astawu/Transmission_TeamOh-/PDR/CAD photos/overview.JPG

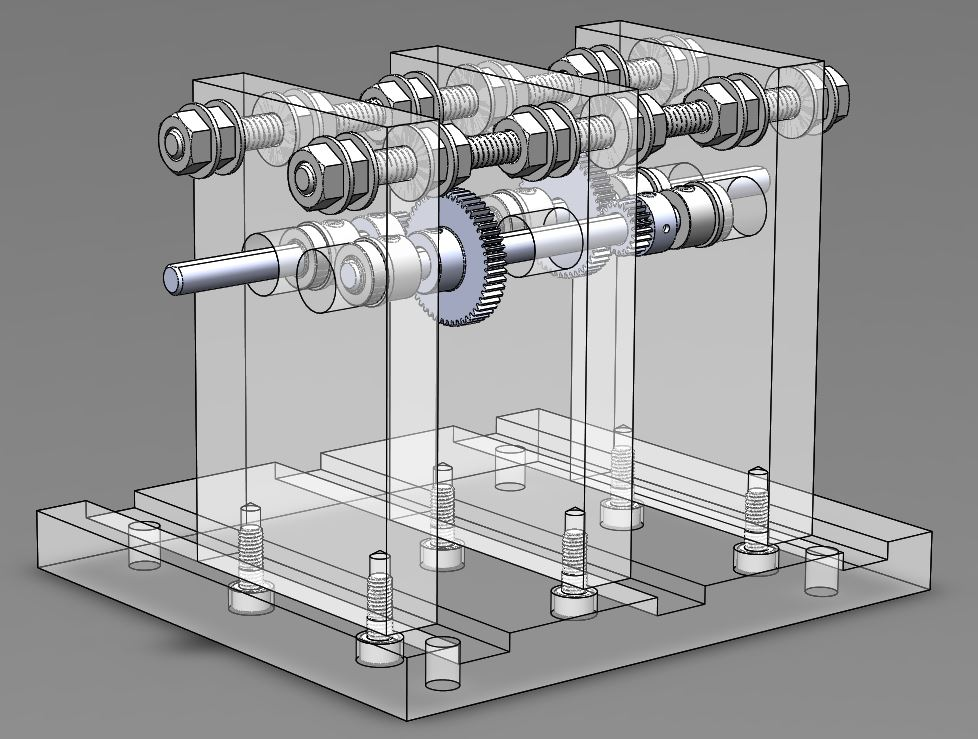
PDR/CAD photos/overview.JPG
