astawu/Transmission_TeamOh-/PDR/CAD photos/side.JPG

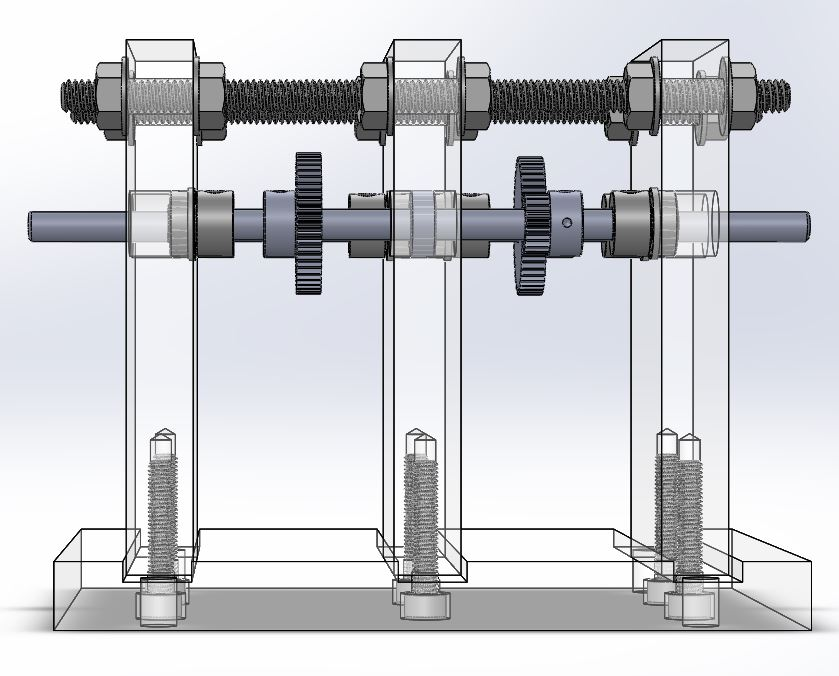
PDR/CAD photos/side.JPG
