astawu/Transmission_TeamOh-/README.md

# Transmission_TeamOh-
Transmission Competition Documents
