astawu/Transmission_TeamOh-/PDR/Transmission Contest PDR.pdf

# Transmission Contest PDR

# Zhong Huang, Cavin Huh, Asta Wu Team Oh

# Drawings and Decisions

# SolidWorks

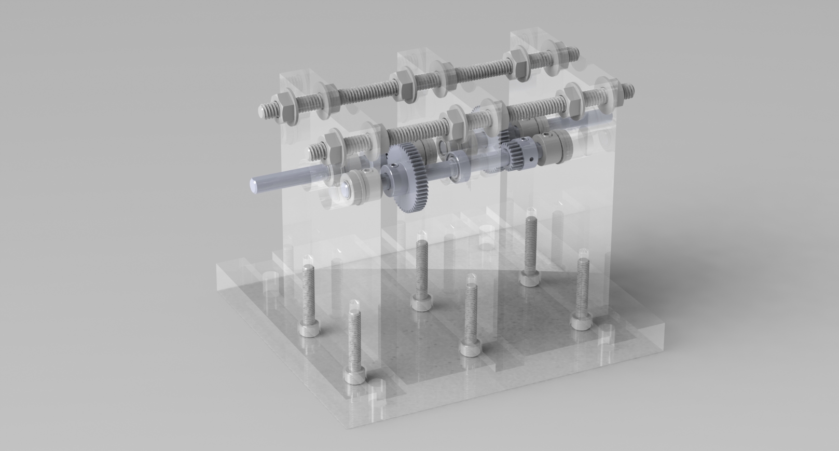
[picture p18: page 3]

# Overall design


# - Two stage inline drive - Three axles using spur

gears – most simple,

# cheap design, allows higher quality parts - 2.5 reduction at each gear interface = 6.25 overall gear ratio - Minimise size

# Gears


## - Gears: 20 teeth to 50 teeth for 2.5 ratio - Small gears instead of big – less inertia - 48 diametral pitch instead of lower values – more teeth for better meshing

## - Aluminium instead of plastic/steel – stronger than plastic, able to machine if needed - Set screw hub cap for D shaft – easily adjustable, strong

## - 20 degree pressure angle – only size available. Would have preferred 14.5 for

better meshing.

## - Wide face width (0.1875) – more contact area

# Bearings / Collars


# - Steel Ball Bearings for better efficiency / lower friction than bushings - Flanged instead of unflanged - so shaft/bearings are constrained - Set screw collars instead of – easy adjustment on D shaft, cheap

# - Smallest OD of ½ inch – fits press fit reamer in shop

# - Extended inner race – collars only contact inner rotating part of

bearing. Minimizes friction.

# - Initially wanted bearings with set screw collars – too expensive

# Supports


# - Machined slots at bottom for close, flat fit - 10-32 set screws - Using threaded rod and nuts for top support – allows for tighter shaft constraining - Flange nut to spread out pressure more - Shaft steel – more rigid than other materials. ¼ inch as most popular bore

size for gears.

# Calculations

# Forces, Normal Stresses, Deflections, Torques (done with maximum input torque)

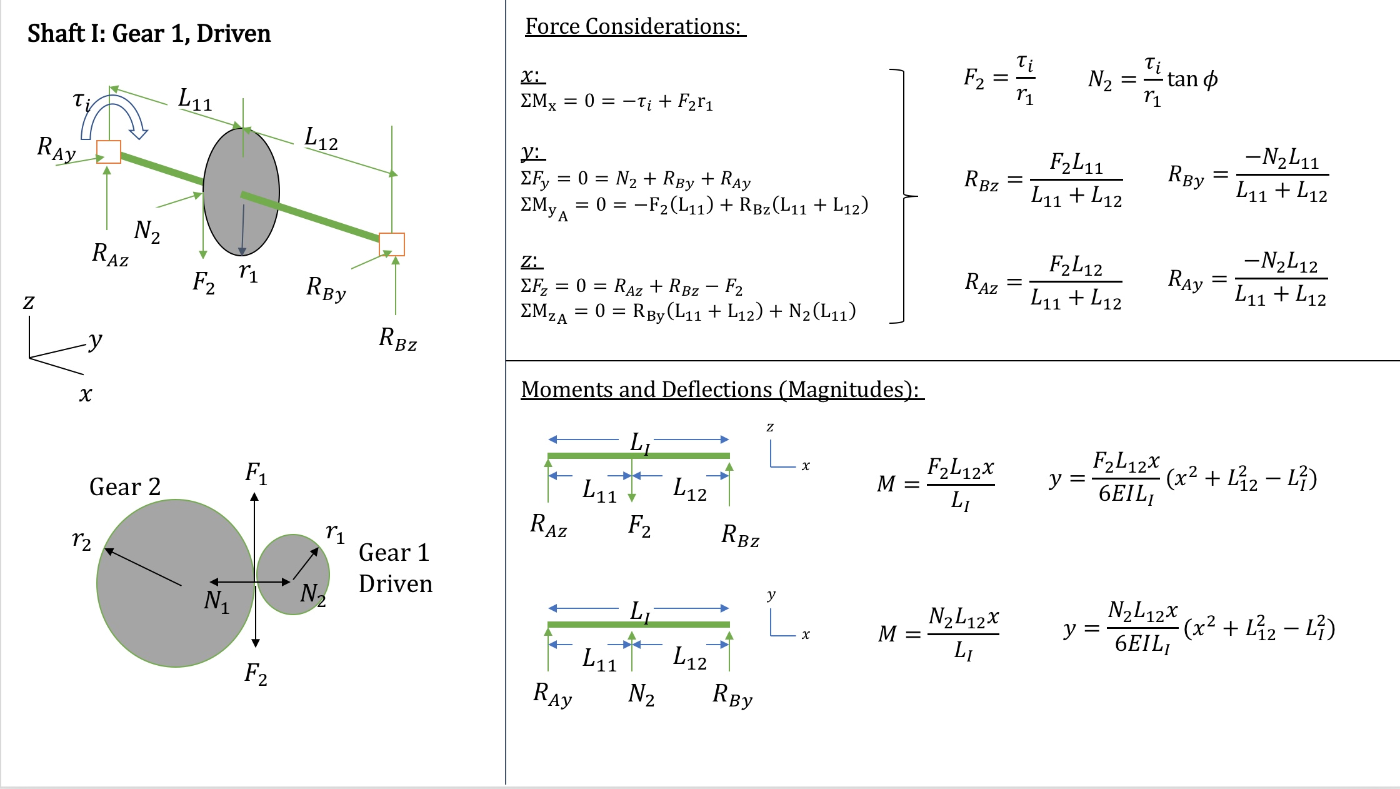
[picture p19: page 9]

Moments:
):
* = ,-./-0
.1

→ *345 = ,-./-.//
.1

6:
* = 7-./-0
.1

→ *345 = 7-./-.//
.1

Specs:
- Gear 1: 20 tooth gear
- D/ = E.G/HI

JK
- L = 20M
- Motor:
- NOP4QQ = 0.133 7S
- TM = 5500 DVS
- NWX = NOP4QQ = 0.1337S
- Shaft I:
- Diameter ¼ in.
- .1 =1.5in
- We assume that the
portion sticking out of the other side of the wall is
negligible
Shaft I: Continued | Force Calculations:

,- = NW
D/

= 0.1337S
0.4167
2 JK

∗

39.3701 JK
1S = lm. n o

7- = NW
D/

tanL = 25.1 7 ∗ tan 20M = p. nm o

Let .// = ./-, we assume that because the shaft is so short, gear placement along the length of the shaft will not cause too much of a difference in our resulting forces and moments; especially since the forces acting on the shaft, as we can see, is fairly small.

uvw = 25.17 ∗

1.5
2 JK ∗

S
39.3701 JK
1.5 JK ∗

S
39.3701 JK

= 12.57 7

uvx = −9.15 7
2 = −4.57 7

uzw = 25.1 7
2 = 12.57 7

uzx = −9.15 7
2 = −4.57 7

Normal Stresses:

*345|w = ,-./-.//
.1

= 25.1 7 ∗

1.5
2 JK ∗

S
39.3701 JK

1.5 JK ∗

S
39.3701 JK = 0.239 7S

*345|x = 7-./-.//
.1

= 0.0871 7S

We get that the maximum moment in both cases is at the location of the gear.

*345/ = 0.220 - + 0.0802 -

/
- = Ä. lmmoÅ

Ç345 = *345/ ∗

0.25
2 JK ∗

1 S
39.3701JK
1
4 É

0.25 JK
2 ∗

1 S
39.3701JK

G = nÄ. n ÑÖÜ

We are well under the yield stress of steel.

<x

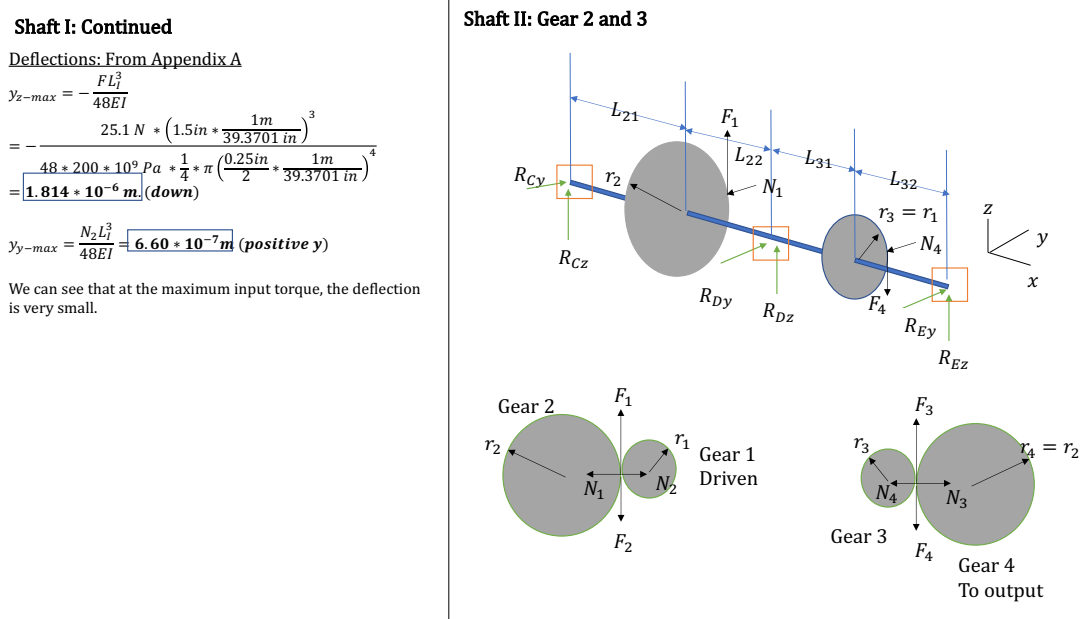
[picture p20: page 11]
= V. WVX ∗ VY⁶Z [. (]^_`); Gear 1 Driven; Gear 2; Gear 3; Gear 4 To output

Shaft II: Gear 2 and 3

Shaft I: Continued
Deflections: From Appendix A

48BC = Z. ZY ∗ VY⁶d[ (e^fghgij k)

We can see that at the maximum input torque, the deflection
is very small.

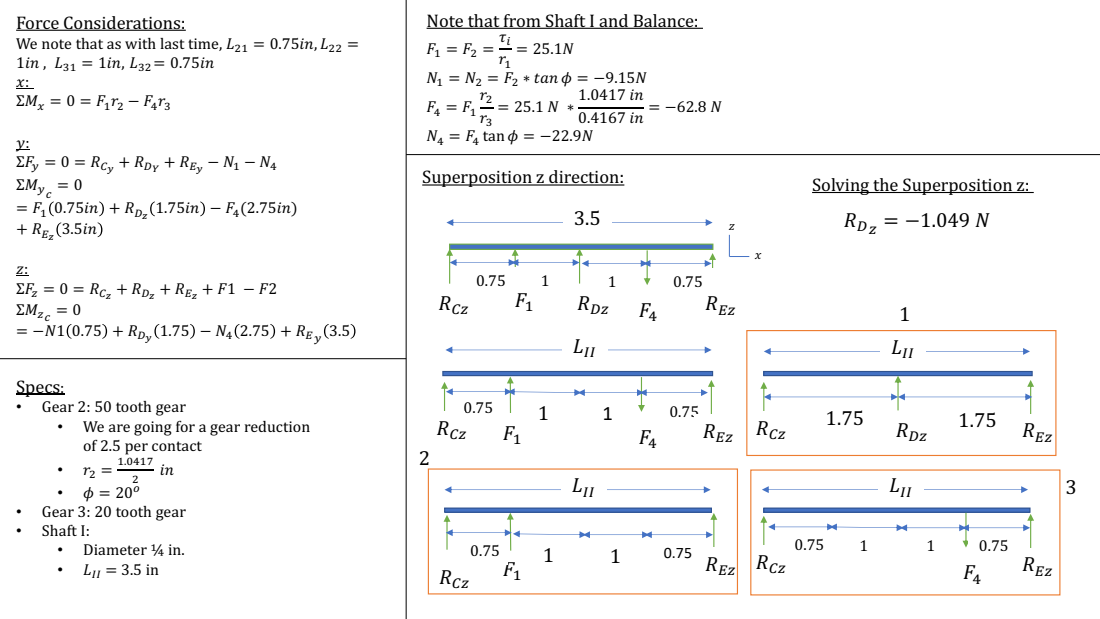
[picture p21: page 12]
I: ΣEJ = 0 = KLM ΣCJS = 0 = E7 0.75=> + KOT 1.75=> − EH(2.75=>) + KQT 3.5=>; 1.75 − RH 2.75 + KQJ 3.5; Superposition z direction:; RH = EH tanh = −22.9R; KLZ; KOZ; KQZ; KQZ H; KQZ 7

Force Considerations:
We note that as with last time, 567 = 0.75=>, 566 =
ΣCD = 0 = E7F6 − EHF@

Note that from Shaft I and Balance:

+ KOP + KQM − R7 − RH

Solving the Superposition z:
KOZ

ΣEZ = 0 = KLT + KOT + KQT + E1 − E2
ΣCZS = 0
= −R1 0.75 + KOM

Specs:
• Gear 2: 50 tooth gear
• We are going for a gear reduction
of 2.5 per contact
• Gear 3: 20 tooth gear
• Shaft I:
• Diameter ¼ in.

3.5 | ,

$0

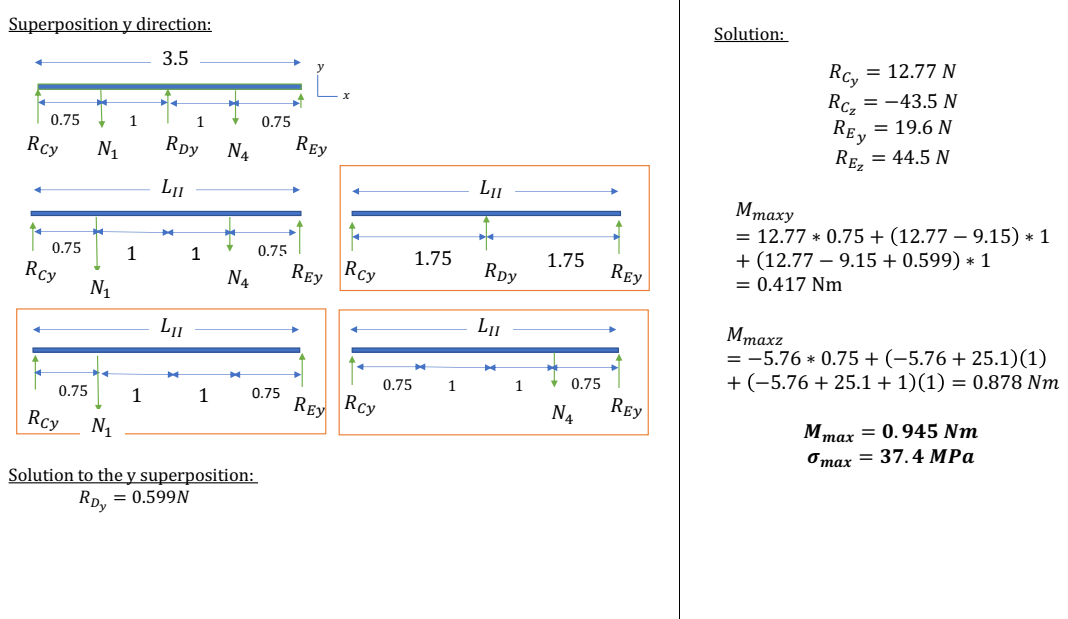
[picture p22: page 13]
Superposition y direction:; Solution:; LMNO# = 12.77 ∗ 0.75 + 12.77 − 9.15 ∗ 1 + 12.77 − 9.15 + 0.599 ∗ 1 = 0.417 Nm; LMNOT = −5.76 ∗ 0.75 + −5.76 + 25.1 1 + −5.76 + 25.1 + 1 1 = 0.878 $V

WXYZ = [. \]^ _X
`XYZ = ab. ] WcY

Solution to the y superposition:

&"

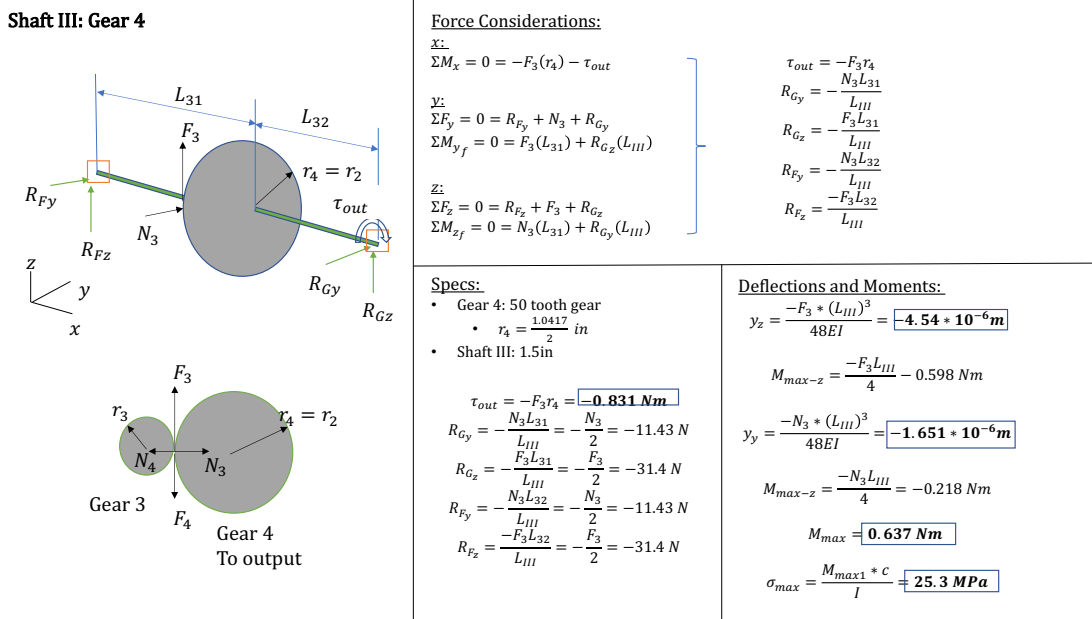
[picture p23: page 14]
Gear 3; Gear 4 To output; CDEF; Force Considerations: <: ΣOP = 0 = −&" !# − CDEF; 9VVV; CDEF = −&"!# 48S = − '"9":; 9VVV 48W = − &"9":; 9VVV 45S = − '"9"%; 9VVV 45W = −&"9"%; = −p. qp ∗ darsf; OtuPr7 = −&"9VVV; =6 = −'" ∗ 9VVV; = −d. sqd ∗ darsf; OtuPr7 = −'"9VVV; ytuP = OtuP: ∗ z

Shaft III: Gear 4

Specs:
• Gear 4: 50 tooth gear
• Shaft III: 1.5in

Deflections and Moments:
=7 = −&" ∗ 9VVV

CDEF = −&"!# = −a. bcd ef

OtuP = a. scx ef

# Peek at the Budget

# Pricing for the Parts

# Bill of Materials

Item | Stock | Price Per Unit | Total Price
20 Tooth Gear | 2 | $16.04 | $32.08
50 Tooth Gear | 2 | $21.99 | $43.98
Stainless Steel Ball Bearing | 6 | $7.00 | $42.00
Ball Bearing | 1 | $5.79 | $5.79
Set Screw Shaft Collar | 6 | $0.99 | $5.94
High Strength Steel Threaded Rod | 1 | $6.88 | $6.88
High Strength Steel Flange Nuts | 1(100) | $6.52 | $6.52

## Total Price of Materials for Project comes out to $143.19

# The Gears

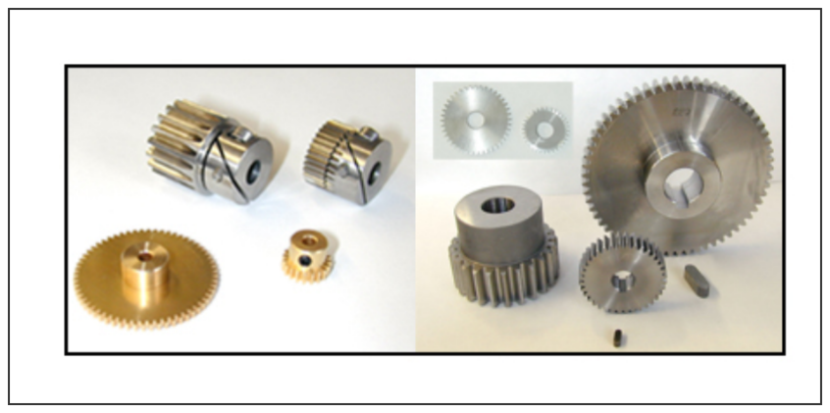
[picture p24: figure]

# 20 Tooth Gear - 48 Pitch Diameter - 20 Degree Pressure Angle - 20 Teeth

# 50 Tooth Gear - 48 Pitch Diameter - 20 Degree Pressure Angle - 50 Teeth

# The Bearings

## Stainless Ball Bearing - For a 0.25” shaft & a 0.5” housing - 0.1875” width - 240lb dynamic load and 90lb static load - Flanged - 0.547” diameter, 0.05” width

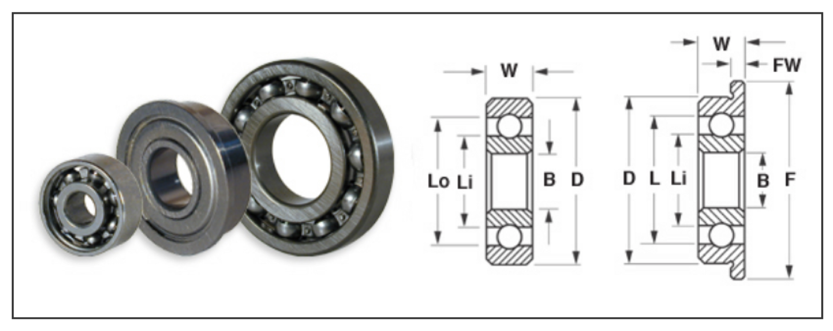
[picture p25: figure]

## Ball Bearing - For a 0.25” shaft and a 0.5” housing - 0.188” width - 123lb dynamic load and 54lb static load - Not Flanged

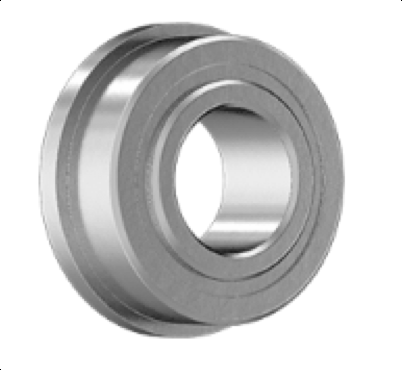
[picture p26: figure]

# Rods and Nuts

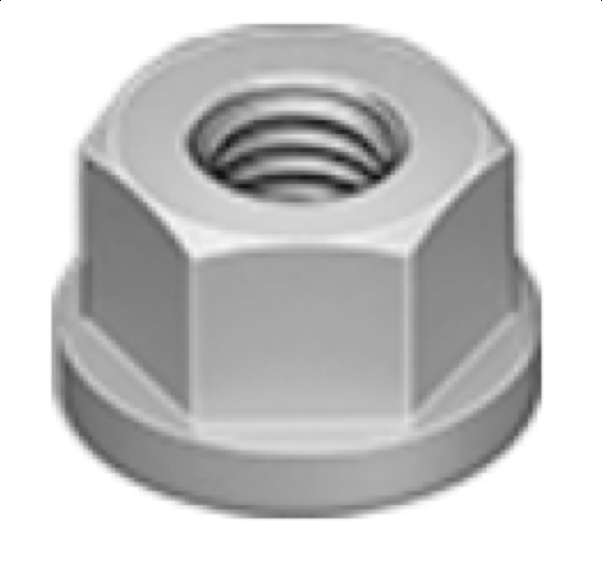
[picture p27: figure]

# - High Strength Steel Flanged Nuts

# - Come in Pack of 100 - 0.4375” width - 0.59375” flange diameter - 0.04” flange width

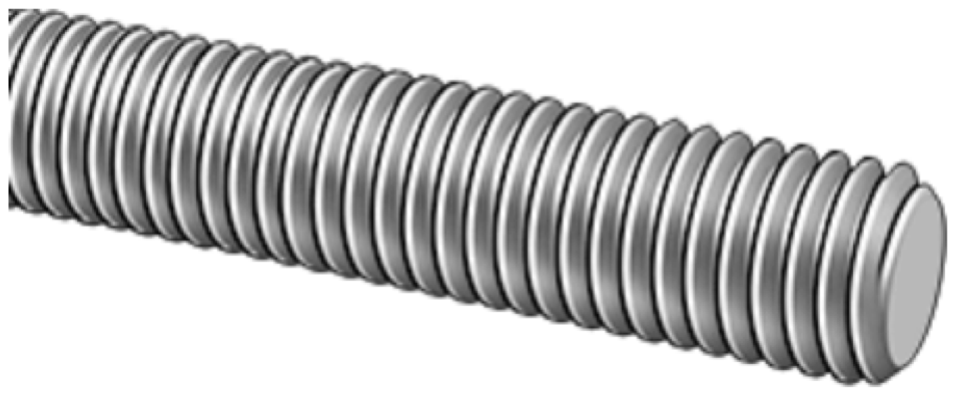
[picture p28: figure]

# - High Strength Steel Threaded Rod

# - Tensile Strength of 115 lbs - 0.25”-20 Thread Size - 1 ft long
