astawu/Transmission_TeamOh-/Team5_Component_list.xlsx

MCMASTER-CARR ORDER | MEMBERS | TEAM # | PART # | DESCRIPTION | QTY | INDIVIDUAL COST | SUBTOTAL | TOTAL | URL
 | Zhong Qian Huang Asta Wu Calvin Huh | 5 | 6432K12 | Set Screw Shaft Collar | 6 | $0.99 | $5.94 | $61.34 | https://www.mcmaster.com/#6432k12/=1cssaze
 |  | 5 | 57155K337 | Flanged Stainless Steel Ball Bearing | 6 | $7.00 | $42.00 |  | https://www.mcmaster.com/#57155k337/=1csscje
 |  | 5 | 90322A656 | High-Strength Steel Threaded Rod | 1 | $6.88 | $6.88 |  | https://www.mcmaster.com/#90322a656/=1cssc82
 |  | 5 | 94902A101 | High-Strength Steel Flanged Nuts | 1 | $6.52 | $6.52 |  | https://www.mcmaster.com/#94902a101/=1cssd0e
 |  | 5 |  |  |  |  | $0.00
 |  | 5 |  |  |  |  | $0.00
 |  | 5 |  |  |  |  | $0.00
 |  | 5 |  |  |  |  | $0.00
 |  | 5 |  |  |  |  | $0.00
 |  | 5 |  |  |  |  | $0.00
 |  | 5 |  |  |  |  | $0.00
SDP_SI ORDER | MEMBERS | TEAM # | PART # | DESCRIPTION | QTY | INDIVIDUAL COST | SUBTOTAL | TOTAL | URL
 | Zhong Qian Huang Asta Wu Calvin Huh | 5 | S1086Z-048A020 | 20 Tooth Aluminum Spur Gear | 2 | $16.04 | $32.08 | $81.85 | http://shop.sdp-si.com/catalog/product/?id=S1086Z-048A020
 |  | 5 | S1086Z-048A050 | 50 Tooth Aluminum Spur Gear | 2 | $21.99 | $43.98 |  | http://shop.sdp-si.com/catalog/product/?id=S1086Z-048A050
 |  | 5 | A 7Y55-PSS5025 | Stainless Steel Ball Bearing | 1 | $5.79 | $5.79 |  | http://shop.sdp-si.com/catalog/product/?id=A_7Y55-PSS5025
 |  | 5 |  |  |  |  | $0.00
 |  | 5 |  |  |  |  | $0.00
 |  | 5 |  |  |  |  | $0.00
 |  | 5 |  |  |  |  | $0.00
 |  | 5 |  |  |  |  | $0.00
 |  | 5 |  |  |  |  | $0.00
 |  | 5 |  |  |  |  | $0.00
 |  | 5 |  |  |  |  | $0.00
FROM MACHINE SHOP | MEMBERS | TEAM # | PART # | DESCRIPTION | QTY | INDIVIDUAL COST | SUBTOTAL | TOTAL | URL
 | Zhong Qian Huang Asta Wu Calvin Huh |  |  | 1/4 inch Steel Rod with D-Profile |  |  | $0.00 | $0.00
 |  |  |  | 10-32 Socket Head Cap screw, Half-inch long |  |  | $0.00
 |  |  |  | 1/2 inch acrylic sheet |  |  | $0.00
 |  |  |  |  |  |  | $0.00
 |  |  |  |  |  |  | $0.00
 |  |  |  |  |  |  | $0.00
 |  |  |  |  |  |  | $0.00
 |  |  |  |  |  |  | $0.00
 |  |  |  |  |  |  | $0.00
 |  |  |  |  |  |  | $0.00
 |  |  |  |  |  |  | $0.00
