astawu/Transmission_TeamOh-/PDR/Bill of Materials.xlsx

Item | Stock | Price Per Unit | Total Price
20 Tooth Gear | 2 | $16.04 | $32.08
59 Tooth Gear | 2 | $21.99 | $43.98
Stainless Steel Ball Bearing | 7 | $7.00 | $49.00
Ball Bearing | 2 | $6.48 | $12.96
Set Screw Shaft Collar | 8 | $0.99 | $7.92
