astawu/Transmission_TeamOh-/transmission CAD/transmission.SLDASM

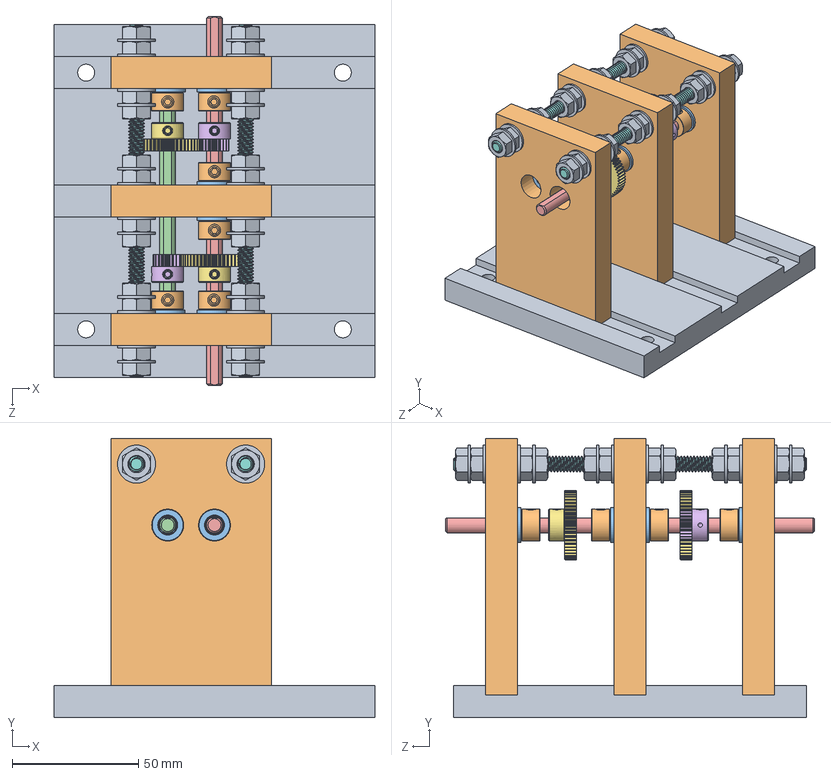
[picture p29: CAD file, 2018-06-04]
transmission CAD/transmission.SLDASM
127.0 x 110.5 x 146.1 mm
Base
Flanged_Bearing_Plate x 3
bearing_flanged x 6
DShaft_3.38
DShaft_1.63 x 2
gear_20_0.4167 x 2
gear_50_1.0417 x 2
threaded_rod_14-20 x 2
94902A101_BLACK PHOSPHATE GRADE 8 STEEL FLANGE NUT x 24
collar x 6
91251A342_BLACK-OXIDE ALLOY STEEL SOCKET HEAD CAP SCREW x 6
