astawu/Transmission_TeamOh-/Cue_Spring loaded/Asta_changes/Cue_spring_loaded.SLDASM

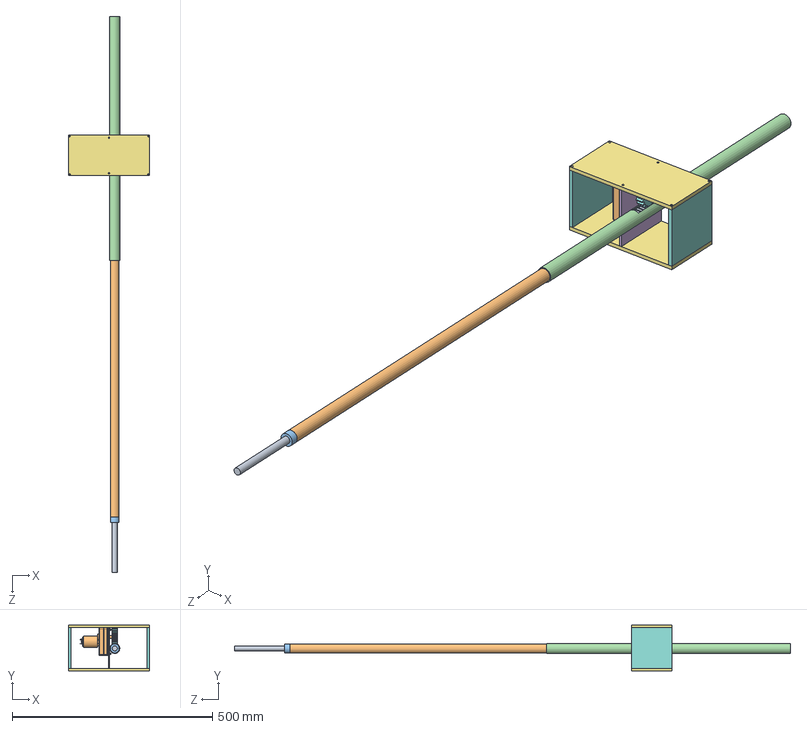
[picture p30: CAD file, 2018-06-09]
Cue_Spring loaded/Asta_changes/Cue_spring_loaded.SLDASM
203.2 x 114.3 x 1389.1 mm
shaft
small_pipe
6391K629_OIL-EMBEDDED SLEEVE BEARING
pipe_connector
9533T300_SELF-ALIGNING LINEAR SLEEVE BRNG
6436K510_TWO-PIECE CLAMP-ON SHAFT COLLAR x 2
9637K270_CUT-TO-LENGTH COMPRESSION SPRING
5172T330_HT-LOAD MTL GEAR--20 DEG PRESSURE ANGLE
5174T300_HT-LOAD MTL GEAR RACK--20 DEG PRESSURE ANGLE
6409K150_COMPACT SQUARE-FACE DC GEARMOTOR
201_catch_middle
201_catch_ring
201_catch_ring_untapped
301_4x4_motorSetScrewPlate
302_3x3_housingbottom x 2
303_4x4_housingside x 2
