astawu/Transmission_TeamOh-/transmission CAD/DShaft_1.63.SLDPRT

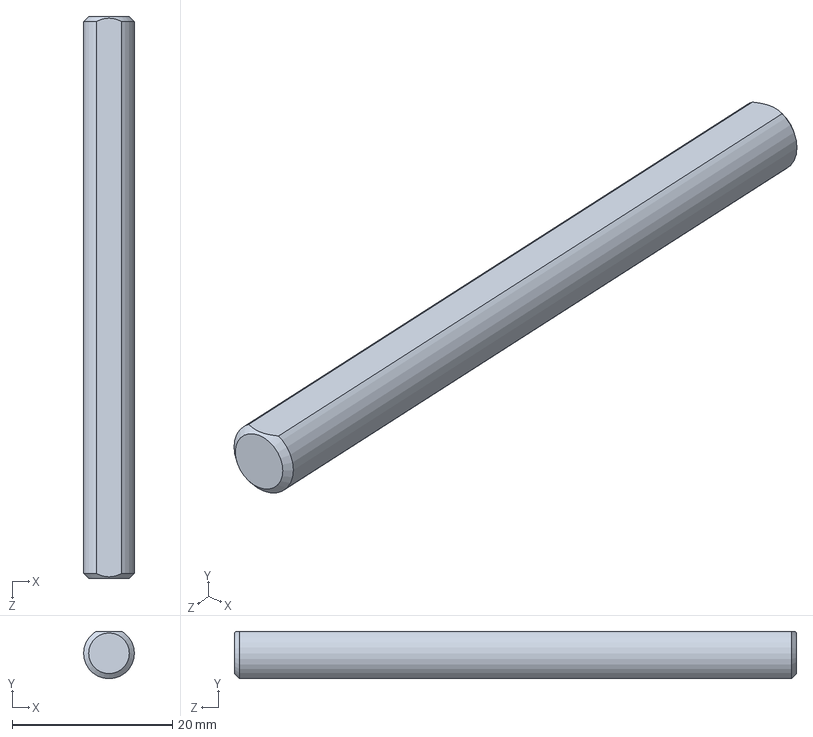
[picture p31: CAD file, 2018-06-04]
transmission CAD/DShaft_1.63.SLDPRT
6.35 x 5.92 x 70.2 mm
