astawu/Transmission_TeamOh-/transmission CAD/gear/SI_s1086z-048a050.stp

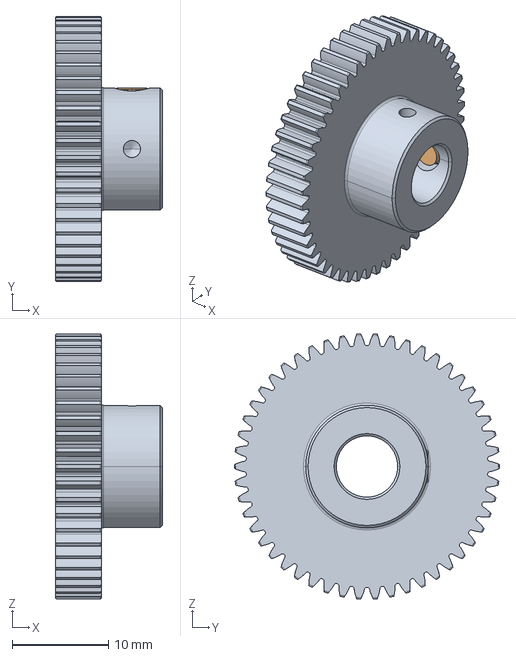
[picture p32: CAD file, 2018-05-10]
transmission CAD/gear/SI_s1086z-048a050.stp
11.1 x 27.5 x 27.5 mm
