astawu/Transmission_TeamOh-/transmission CAD/gear/SDP_a_7y55-pss5025.stp

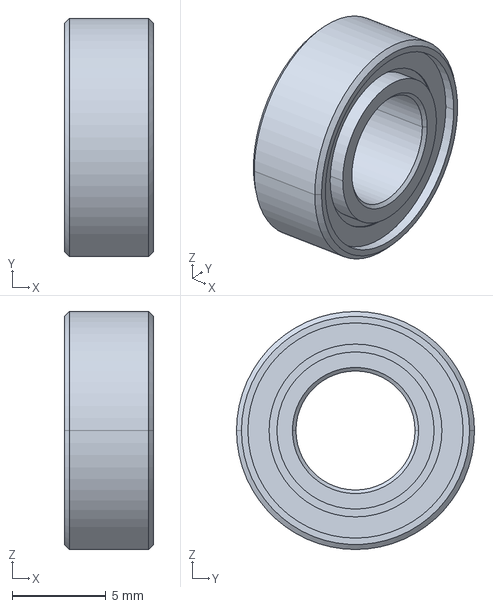
[picture p33: CAD file, 2018-05-10]
transmission CAD/gear/SDP_a_7y55-pss5025.stp
4.76 x 12.7 x 12.7 mm
