astawu/Transmission_TeamOh-/transmission CAD/DShaft_3.38.SLDPRT

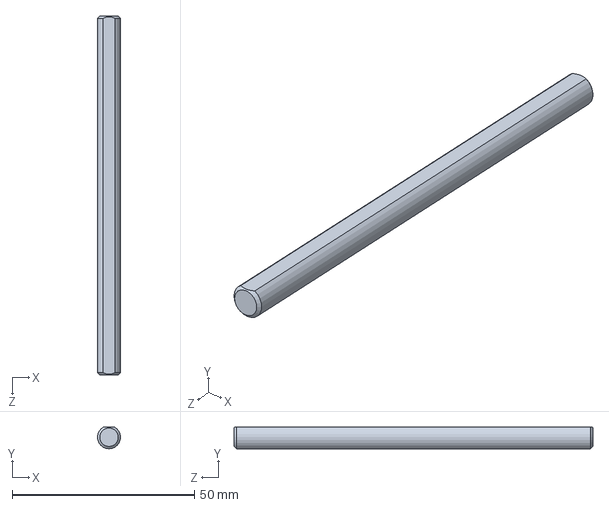
[picture p34: CAD file, 2018-06-04]
transmission CAD/DShaft_3.38.SLDPRT
6.35 x 5.92 x 98.6 mm
