astawu/Transmission_TeamOh-/transmission CAD/gear/SI_s1086z-048a020.stp

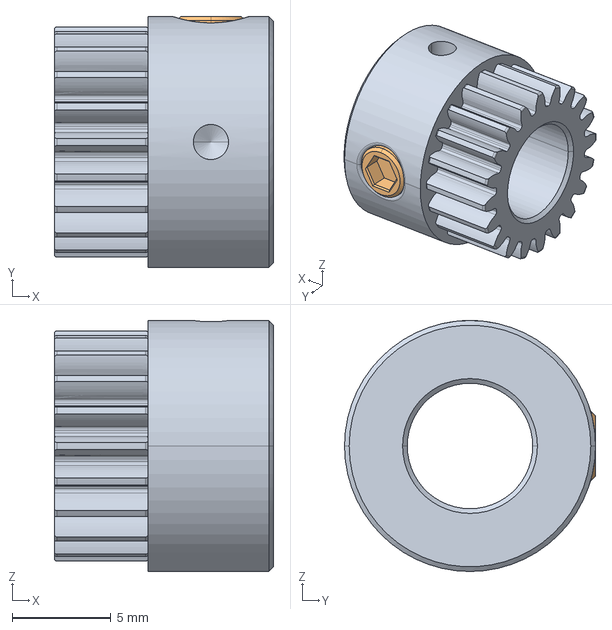
[picture p35: CAD file, 2018-05-09]
transmission CAD/gear/SI_s1086z-048a020.stp
11.1 x 12.7 x 12.7 mm
