astawu/Transmission_TeamOh-/Cue_Spring loaded/Asta_changes/201_catch_ring.SLDPRT

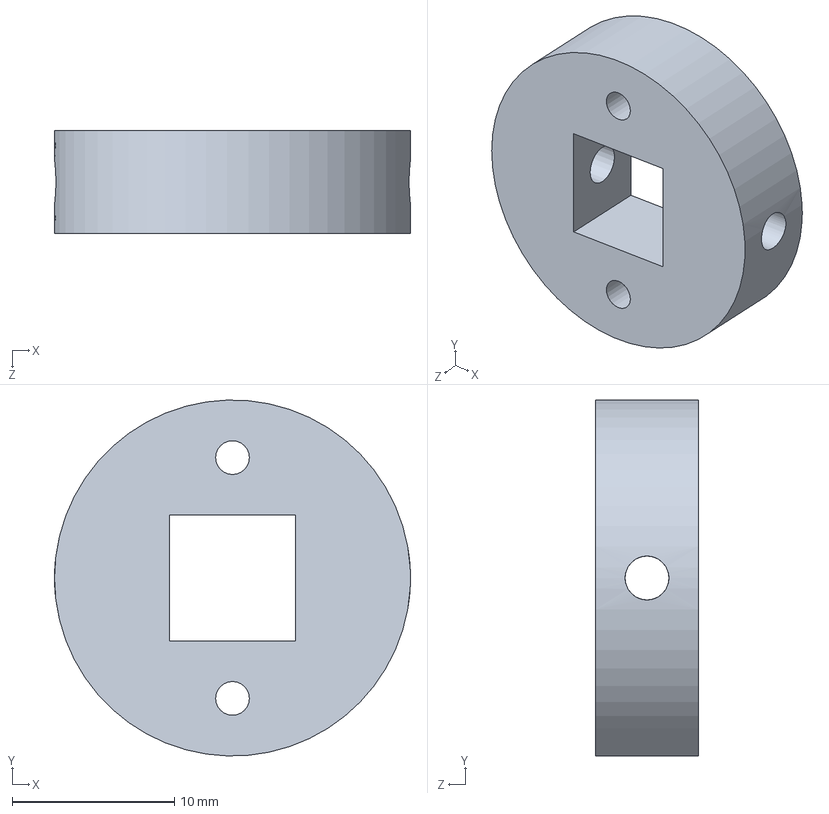
[picture p36: CAD file, 2018-06-09]
Cue_Spring loaded/Asta_changes/201_catch_ring.SLDPRT
22.0 x 22.0 x 6.35 mm
