astawu/Transmission_TeamOh-/transmission CAD/Flanged_Bearing_Plate.SLDPRT

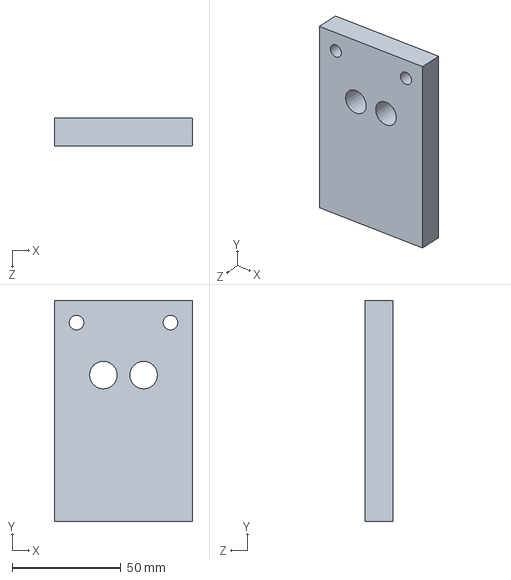
[picture p37: CAD file, 2018-05-14]
transmission CAD/Flanged_Bearing_Plate.SLDPRT
63.5 x 101.6 x 12.7 mm
