astawu/Transmission_TeamOh-/transmission CAD/gear/SI_s1086z-048a060.stp

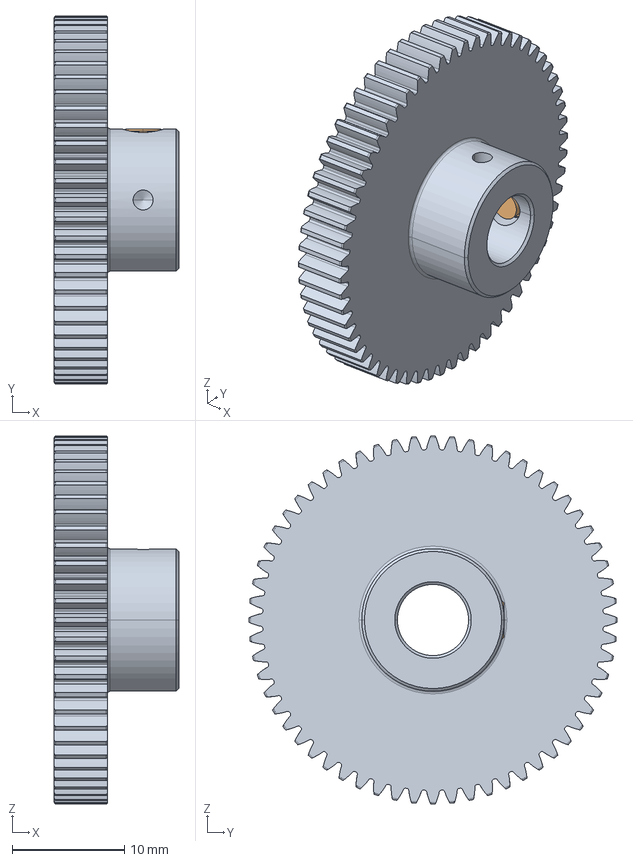
[picture p38: CAD file, 2018-05-09]
transmission CAD/gear/SI_s1086z-048a060.stp
11.1 x 32.8 x 32.8 mm
