astawu/Transmission_TeamOh-/Cue_Spring loaded/Asta_changes/201_catch_middle.SLDPRT

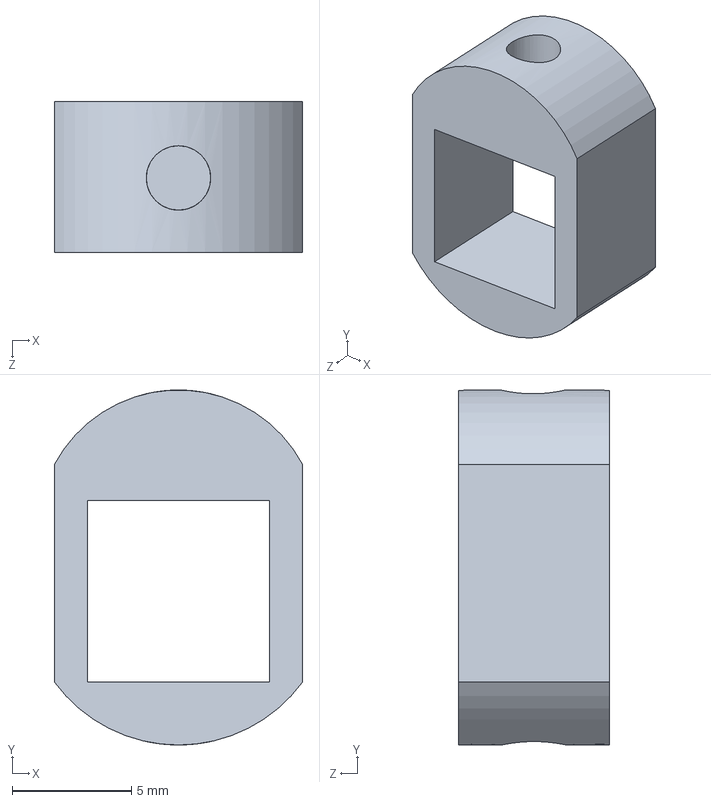
[picture p39: CAD file, 2018-06-09]
Cue_Spring loaded/Asta_changes/201_catch_middle.SLDPRT
10.4 x 14.9 x 6.35 mm
