astawu/Transmission_TeamOh-/Cue_Spring loaded/Asta_changes/rack&catchpart_drawingforwaterjet.SLDPRT

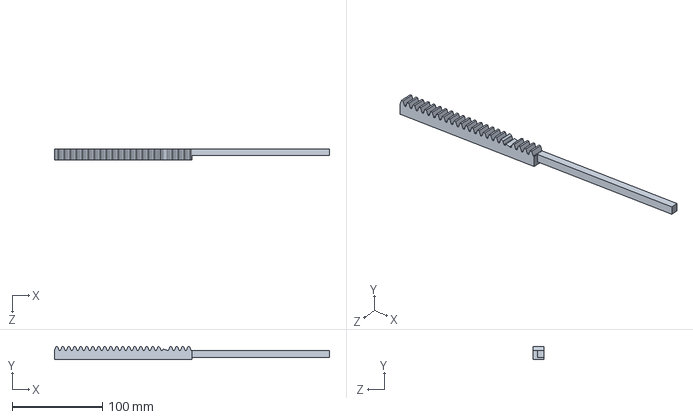
[picture p40: CAD file, 2018-06-09]
Cue_Spring loaded/Asta_changes/rack&catchpart_drawingforwaterjet.SLDPRT
304.8 x 14.9 x 12.7 mm
