astawu/Transmission_TeamOh-/Cue_Spring loaded/Asta_changes/303_4x4_housingside.SLDPRT

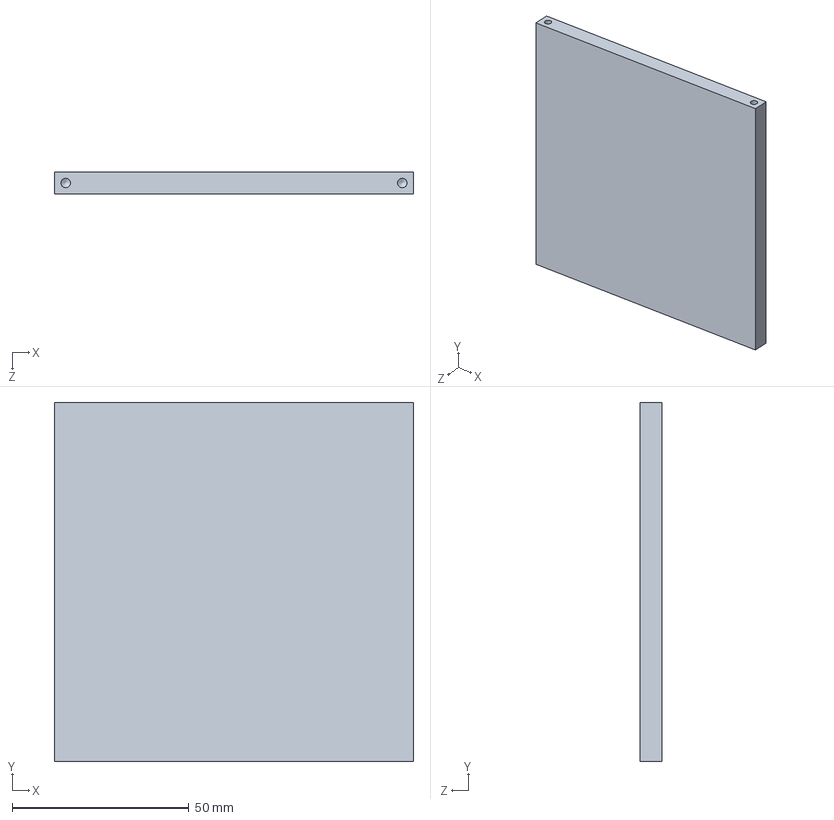
[picture p41: CAD file, 2018-06-09]
Cue_Spring loaded/Asta_changes/303_4x4_housingside.SLDPRT
101.6 x 101.6 x 6.35 mm
