astawu/Transmission_TeamOh-/transmission CAD/Base.SLDPRT

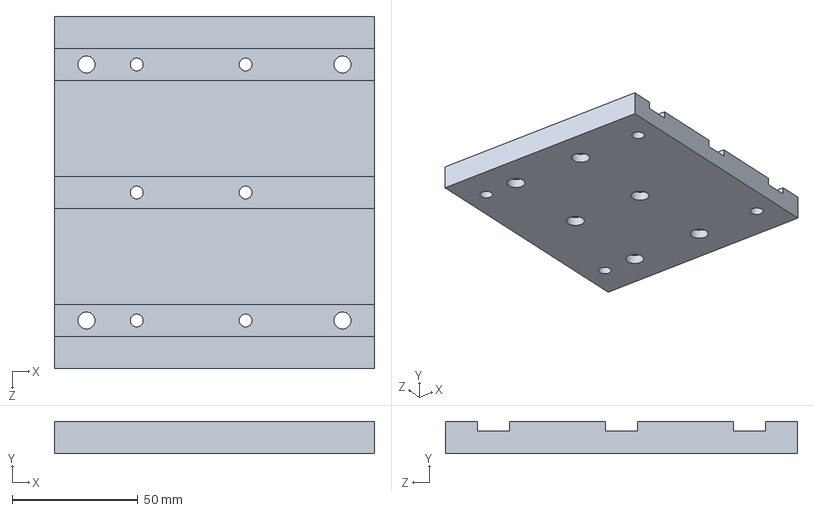
[picture p42: CAD file, 2018-05-10]
transmission CAD/Base.SLDPRT
127.0 x 12.7 x 139.7 mm
