astawu/Transmission_TeamOh-/Cue_Spring loaded/Asta_changes/pipe_connector.SLDPRT

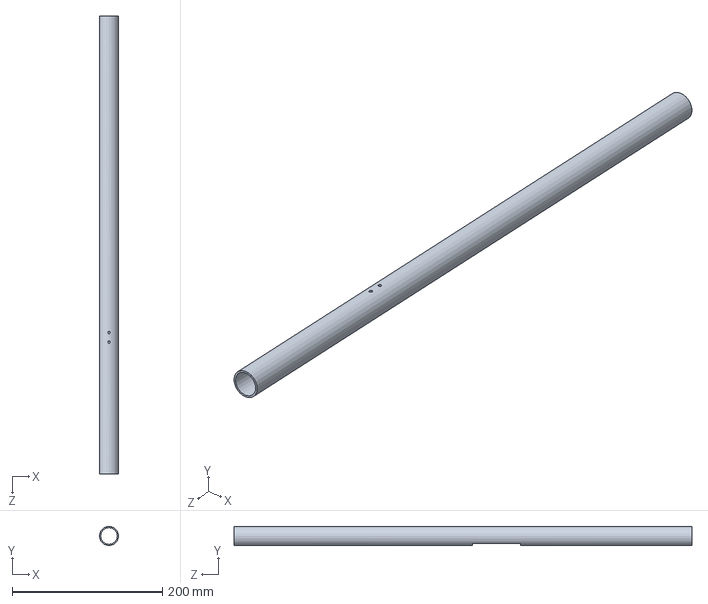
[picture p43: CAD file, 2018-06-09]
Cue_Spring loaded/Asta_changes/pipe_connector.SLDPRT
25.4 x 25.4 x 609.6 mm
