astawu/Transmission_TeamOh-/transmission CAD/Top.SLDPRT

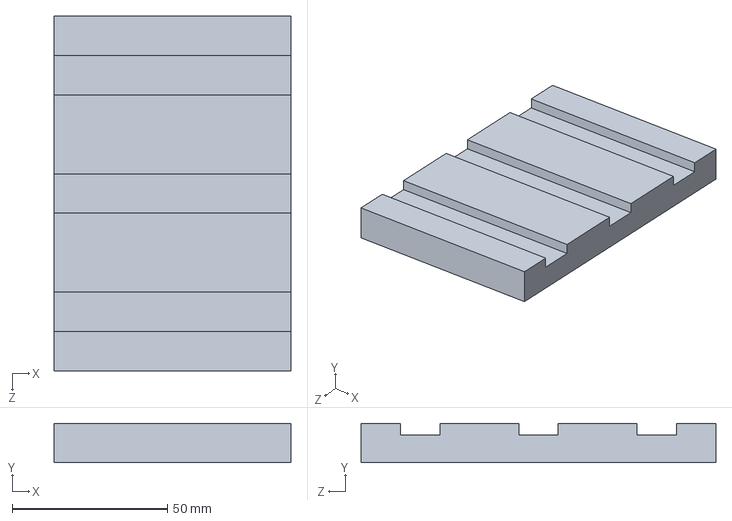
[picture p44: CAD file, 2018-05-10]
transmission CAD/Top.SLDPRT
76.2 x 12.7 x 114.3 mm
