astawu/Transmission_TeamOh-/Cue_Spring loaded/Asta_changes/302_3x3_housingbottom.SLDPRT

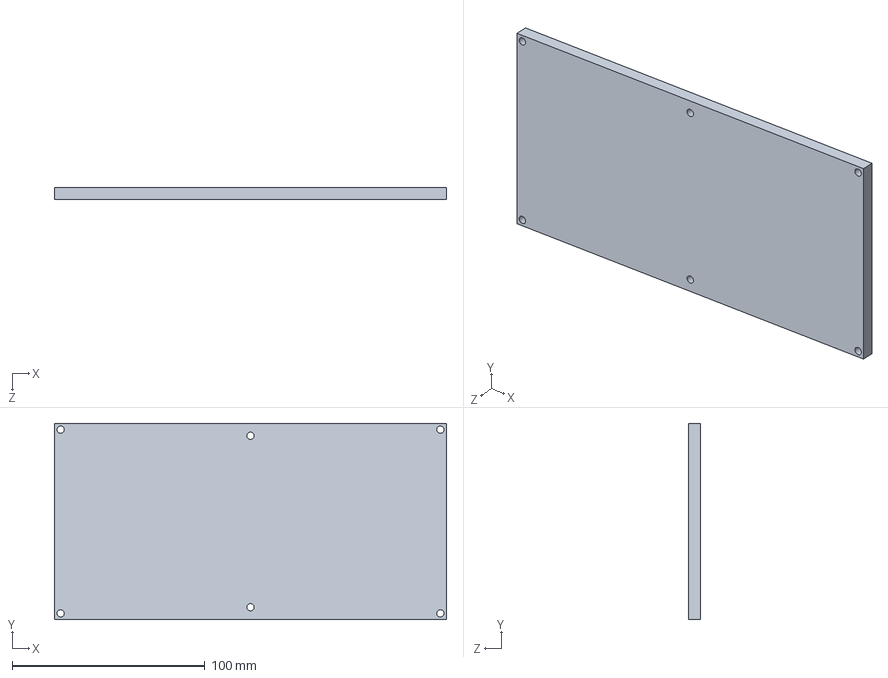
[picture p45: CAD file, 2018-06-09]
Cue_Spring loaded/Asta_changes/302_3x3_housingbottom.SLDPRT
203.2 x 101.6 x 6.35 mm
