astawu/Transmission_TeamOh-/transmission CAD/Round_bearing_plate.SLDPRT

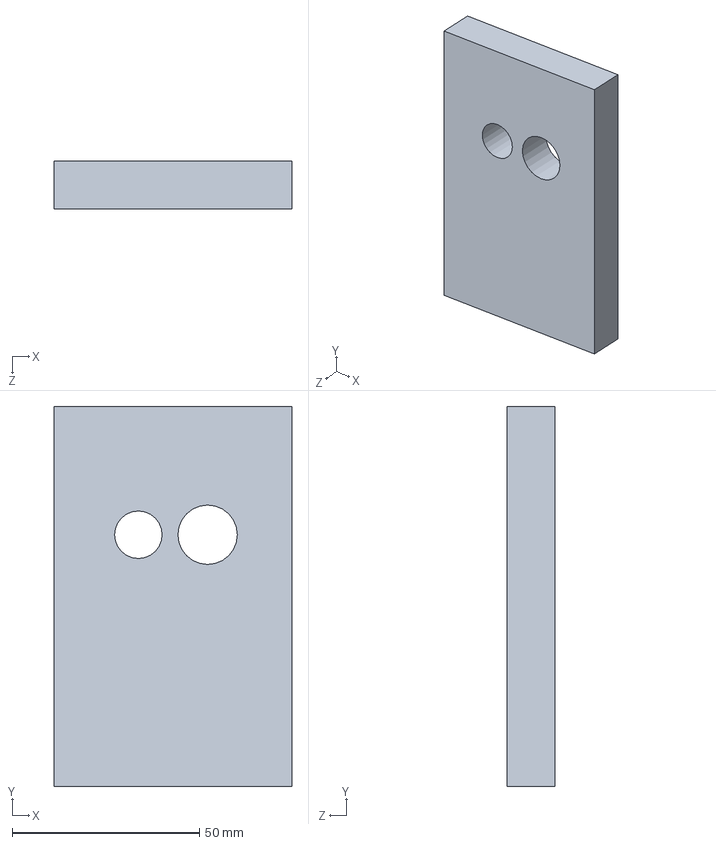
[picture p46: CAD file, 2018-05-10]
transmission CAD/Round_bearing_plate.SLDPRT
63.5 x 101.6 x 12.7 mm
