astawu/Transmission_TeamOh-/Cue_Spring loaded/Asta_changes/201_catch_ring_untapped.SLDPRT

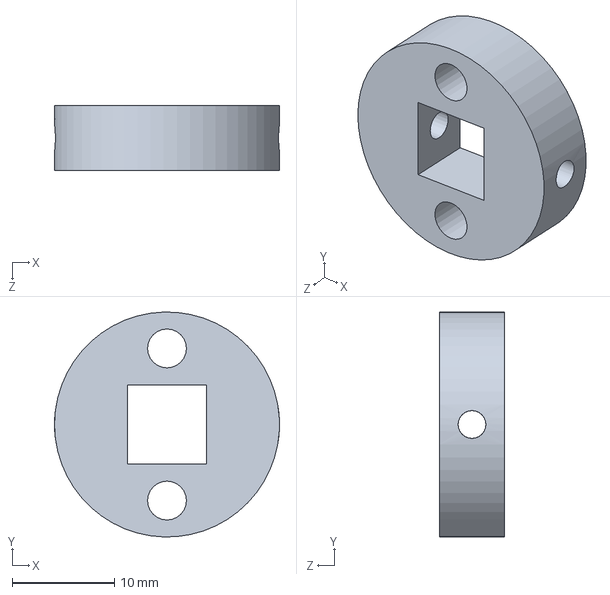
[picture p47: CAD file, 2018-06-04]
Cue_Spring loaded/Asta_changes/201_catch_ring_untapped.SLDPRT
22.0 x 22.0 x 6.35 mm
