astawu/Transmission_TeamOh-/transmission CAD/threaded_rod_14-20.SLDPRT

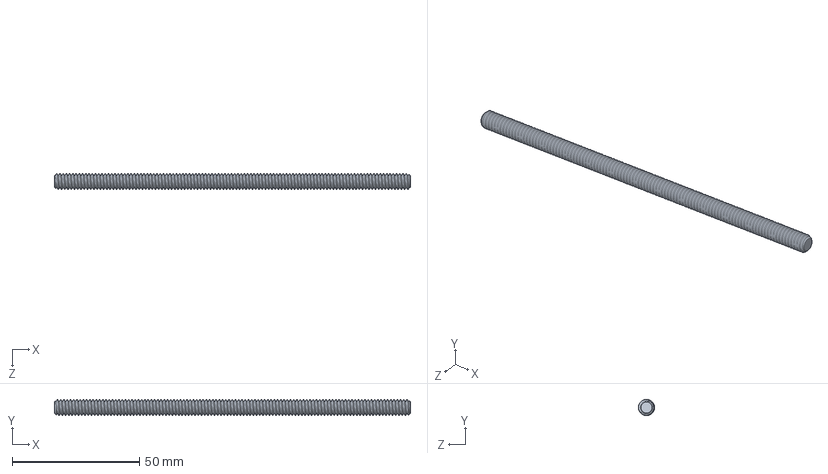
[picture p48: CAD file, 2018-05-10]
transmission CAD/threaded_rod_14-20.SLDPRT
139.7 x 6.35 x 6.35 mm
