astawu/Transmission_TeamOh-/transmission CAD/collar.SLDPRT

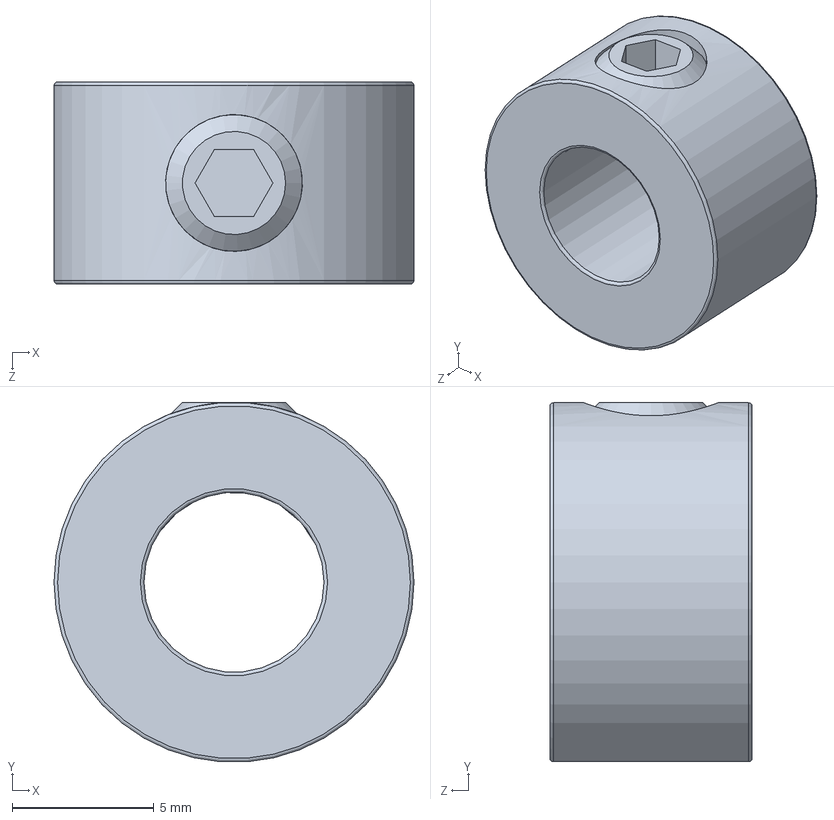
[picture p49: CAD file, 2018-05-10]
transmission CAD/collar.SLDPRT
12.7 x 12.7 x 7.14 mm
