astawu/Transmission_TeamOh-/Cue_Spring loaded/Asta_changes/shaft.SLDPRT

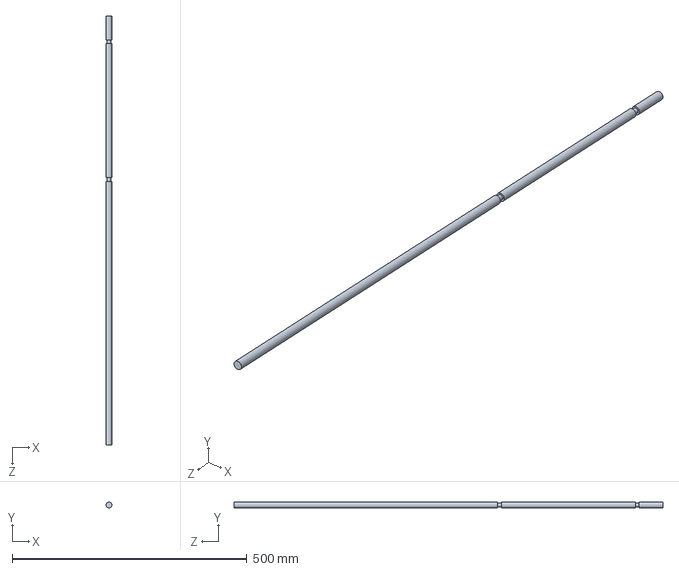
[picture p50: CAD file, 2018-06-04]
Cue_Spring loaded/Asta_changes/shaft.SLDPRT
12.7 x 12.7 x 914.4 mm
