astawu/Transmission_TeamOh-/transmission CAD/bearing_flanged.SLDPRT

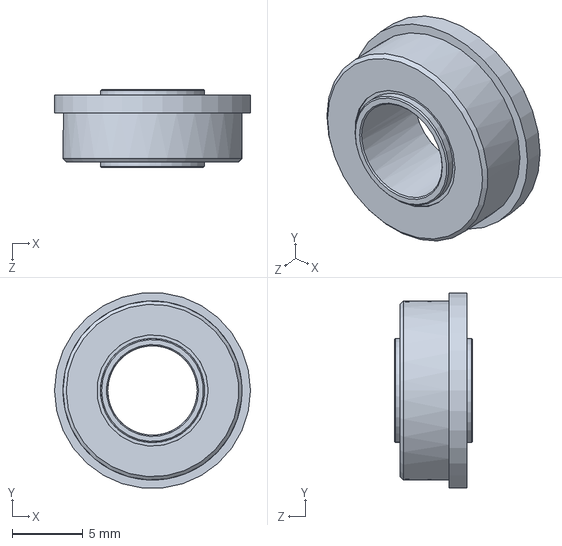
[picture p51: CAD file, 2018-05-10]
transmission CAD/bearing_flanged.SLDPRT
13.9 x 13.8 x 5.56 mm
