astawu/Transmission_TeamOh-/Cue_Spring loaded/Asta_changes/small_pipe.SLDPRT

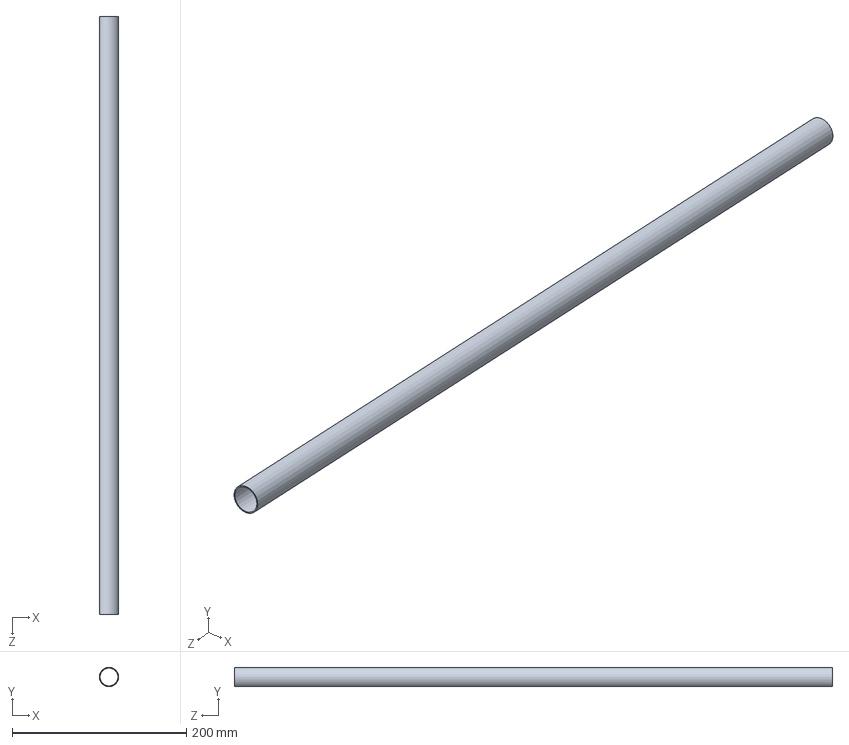
[picture p52: CAD file, 2018-06-04]
Cue_Spring loaded/Asta_changes/small_pipe.SLDPRT
22.2 x 22.2 x 685.8 mm
