astawu/Transmission_TeamOh-/transmission CAD/bearing.SLDPRT

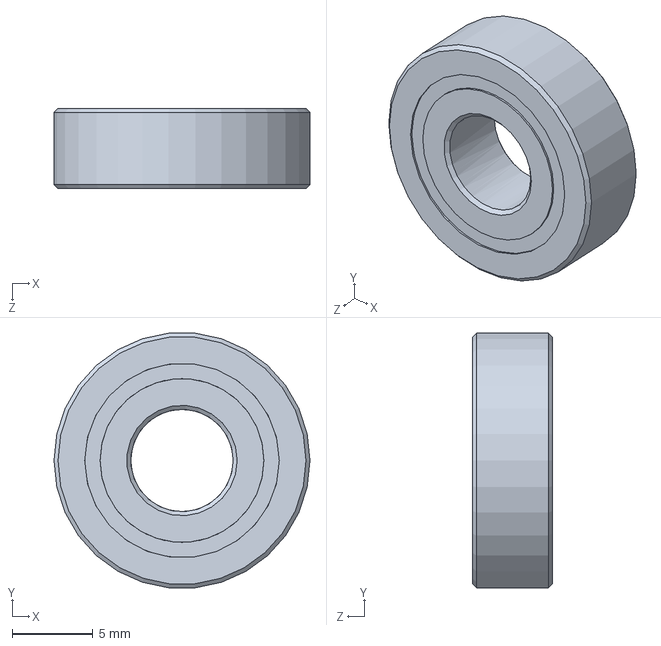
[picture p53: CAD file, 2018-05-10]
transmission CAD/bearing.SLDPRT
15.9 x 15.8 x 4.98 mm
