astawu/Transmission_TeamOh-/(list of files, cad)

Other CAD files:
Cue_Spring loaded/Asta_changes/202_rack&catch_withgroove.SLDPRT
transmission CAD/gear_50_1.0417.SLDPRT
transmission CAD/bearing_noflange.SLDPRT
transmission CAD/gear_20_0.4167.SLDPRT
transmission CAD/gear_60_1.25.SLDPRT
Cue_Spring loaded/Asta_changes/301_4x4_motorSetScrewPlate.SLDPRT
Cue_Spring loaded/Asta_changes/5172T330_HT-LOAD MTL GEAR--20 DEG PRESSURE ANGLE.SLDPRT
Cue_Spring loaded/Asta_changes/5174T300_HT-LOAD MTL GEAR RACK--20 DEG PRESSURE ANGLE.SLDPRT
Cue_Spring loaded/Asta_changes/6391K629_OIL-EMBEDDED SLEEVE BEARING.SLDPRT
Cue_Spring loaded/Asta_changes/6409K150_COMPACT SQUARE-FACE DC GEARMOTOR.SLDPRT
Cue_Spring loaded/Asta_changes/6436K141_TWO-PIECE CLAMP-ON SHAFT COLLAR.SLDPRT
Cue_Spring loaded/Asta_changes/6436K510_TWO-PIECE CLAMP-ON SHAFT COLLAR (1).SLDPRT
Cue_Spring loaded/Asta_changes/6436K510_TWO-PIECE CLAMP-ON SHAFT COLLAR.SLDPRT
Cue_Spring loaded/Asta_changes/6436K610_TWO-PIECE CLAMP-ON SHAFT COLLAR.SLDPRT
Cue_Spring loaded/Asta_changes/9533T300_SELF-ALIGNING LINEAR SLEEVE BRNG.SLDPRT
Cue_Spring loaded/Asta_changes/9637K270_CUT-TO-LENGTH COMPRESSION SPRING.SLDPRT
transmission CAD/6432K120_SET SCREW SHAFT COLLAR.SLDPRT
transmission CAD/91251A342_BLACK-OXIDE ALLOY STEEL SOCKET HEAD CAP SCREW.SLDPRT
transmission CAD/91251A347_BLACK-OXIDE ALLOY STEEL SOCKET HEAD CAP SCREW.SLDPRT
transmission CAD/94902A101_BLACK PHOSPHATE GRADE 8 STEEL FLANGE NUT.SLDPRT
transmission CAD/Drawings/Base.SLDDRW
transmission CAD/Drawings/Flanged_Bearing_Plate.SLDDRW
