astawu/Transmission_TeamOh-/(commit log)

2018-05-09 added parts for bearing and gears
    [SI_s1086z-048a020.stp, SI_s1086z-048a060.stp, bearing.SLDPRT, bearing_flanged.SLDPRT, gear_20_0.4167.SLDPRT, gear_60_1.25.SLDPRT]
2018-05-10 Added parts for transmission
    [Base.SLDPRT, DShaft_0.25.SLDPRT, Flanged_Bearing_Plate.SLDPRT, Round_bearing_plate.SLDPRT, bearing_flanged.SLDPRT, collar.SLDPRT]
2018-05-10 Finalized assembly.
    [6432K120_SET SCREW SHAFT COLLAR.SLDPRT, 91251A347_BLACK-OXIDE ALLOY STEEL SOCKET HEAD CAP SCREW.SLDPRT, 94902A101_BLACK PHOSPHATE GRADE 8 STEEL FLANGE NUT.SLDPRT, Base.SLDPRT, DShaft_0.25.SLDPRT, DShaft_1.63.SLDPRT, DShaft_3.38.SLDPRT, Flanged_Bearing_Plate.SLDPRT]
2018-05-10 Added powerpoint slides, Finalized transmission assembly.
    [91251A347_BLACK-OXIDE ALLOY STEEL SOCKET HEAD CAP SCREW.SLDPRT, Base.SLDPRT, Flanged_Bearing_Plate.SLDPRT, transmission.SLDASM]
2018-05-10 Updated powerpoint
2018-05-10 Added render
    [Bill of Materials.xlsx, transmission.SLDASM]
2018-05-14 Added design elaboration on summary
    [91251A342_BLACK-OXIDE ALLOY STEEL SOCKET HEAD CAP SCREW.SLDPRT, Flanged_Bearing_Plate.SLDPRT, transmission.SLDASM]
2018-05-14 added drawings and BOM
    [Base.SLDDRW, Flanged_Bearing_Plate.SLDDRW, ME14 BOM - SPRING 2018 Team 5.xlsx]
2018-06-04 Added CAD files for mechanical pool cue.
    [5172T330_HT-LOAD MTL GEAR--20 DEG PRESSURE ANGLE.SLDPRT, 5174T300_HT-LOAD MTL GEAR RACK--20 DEG PRESSURE ANGLE.SLDPRT, 6391K629_OIL-EMBEDDED SLEEVE BEARING.SLDPRT, 6409K150_COMPACT SQUARE-FACE DC GEARMOTOR.SLDPRT, 6436K141_TWO-PIECE CLAMP-ON SHAFT COLLAR.SLDPRT, 6436K510_TWO-PIECE CLAMP-ON SHAFT COLLAR.SLDPRT, 9533T300_SELF-ALIGNING LINEAR SLEEVE BRNG.SLDPRT, 9637K270_CUT-TO-LENGTH COMPRESSION SP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]
